Counterfeiter/NespressoBot-PCB/ProductionInfo/silkscreen_example_text_small.jpg

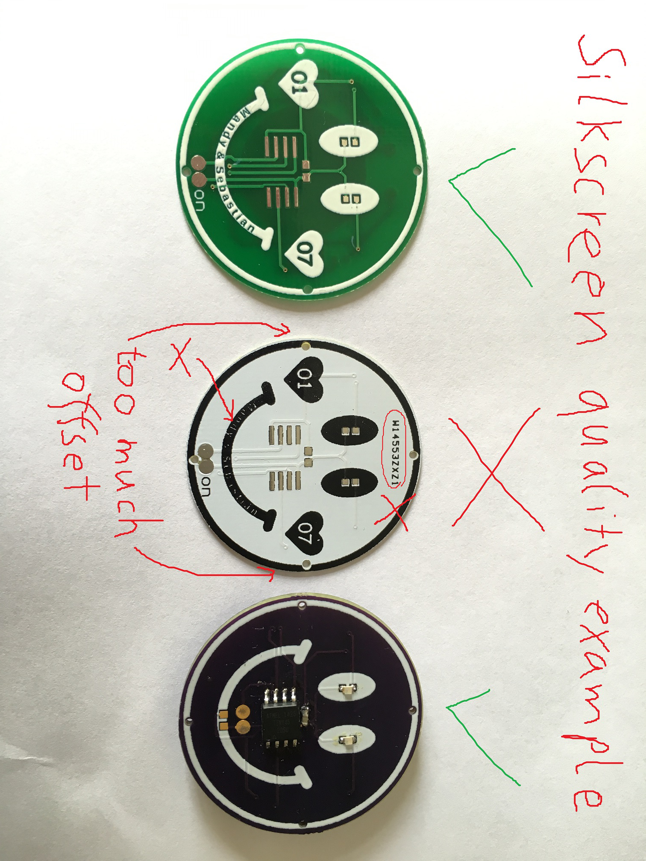
ProductionInfo/silkscreen_example_text_small.jpg
