Counterfeiter/NespressoBot-PCB/Smilie_clean.bmp

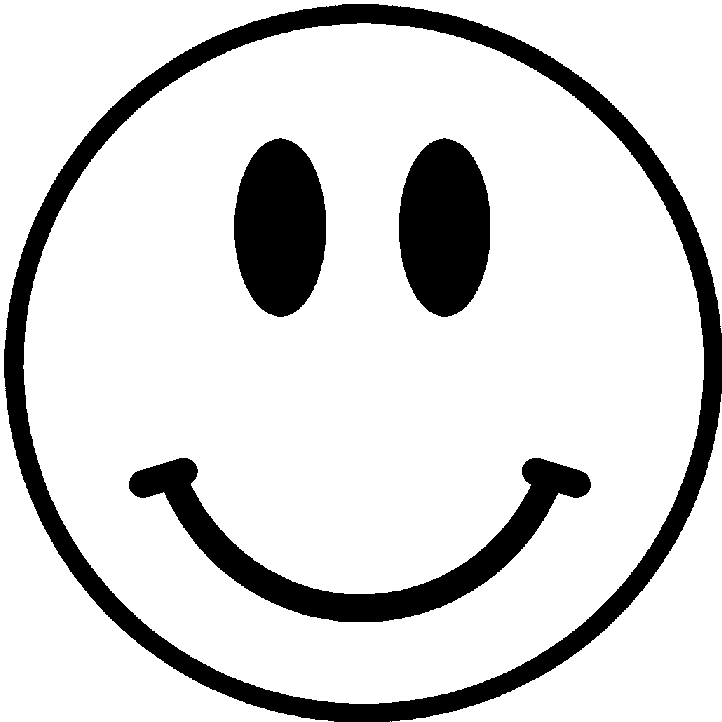
Smilie_clean.bmp
