Counterfeiter/NespressoBot-PCB/smilie_face_raw_small_400dpi.bmp

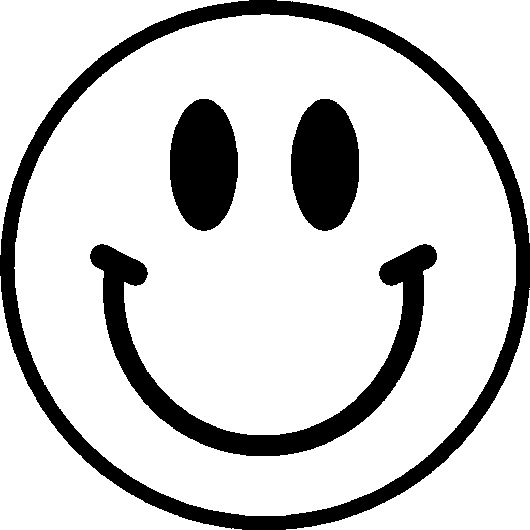
smilie_face_raw_small_400dpi.bmp
