Counterfeiter/NespressoBot-PCB/WeddingBot_BOM.ods

Nr. | Name | Designator | Package | Part-Nr. | Mouser Part-Nr. | Units | Units for Price | Price € | Price*Unit €
1 | CR1220 Battery Holder SMD | U2 |  | S8201-46R | 855-S8201-46R | 1 | 1000 | 0,27 € | 0,27 €
2 | PCB d=35 mm, 1 mm |  |  | Stopcolor: w, Silkscreen: b | good quality | 1 | 1000 | 0,4 | 0,4
3 | Microcontroller | U1 | SO8 | ATTINY45-20SUR | 556-ATTINY45-20SUR | 1 | 1000 | 0,601 | 0,601
4 | Piezo |  |  | 20PCS 27mm Piezo Elements Sounder Sensor Trigger Drum Disc | (Ebay: survy2014) | 1 | 100 | 0,121 | 0,121
6 | Kingbright LED |  | 1206 | APTR3216SGC | 604-APTR3216SGC | 2 | 2000 | 0,05 | 0,1
8 | Res 100 |  | 0603 |  |  | 3 |  | 0,0005 | 0,0015
9 | Cap 100 nF (10 V min) |  | 0603 | C0603C104K4RACTU | 80-C0603C104K4R | 1 | 1000 | 0,005 | 0,005
10 | CR1220 Batterie 50 mAh |  |  | maxell CR1220 | Pollin (270 955)?! | 1 | 100 | 0,47 | 0,47
11 | Eigenleistung |  |  | 10 min (Programmieren, Kleben, Löten, Zurödeln) |  |  |  |  | 0
 |  |  |  |  |  |  | Overall:
 |  |  |  |  |  |  | 1000 |  | 1,9665 | EURO/Unit
 |  |  |  |  |  |  |  |  | 1966,5 | EURO
