Counterfeiter/NespressoBot-PCB/weddingbot.brd

## EAGLE design weddingbot.brd (2018-04-13)

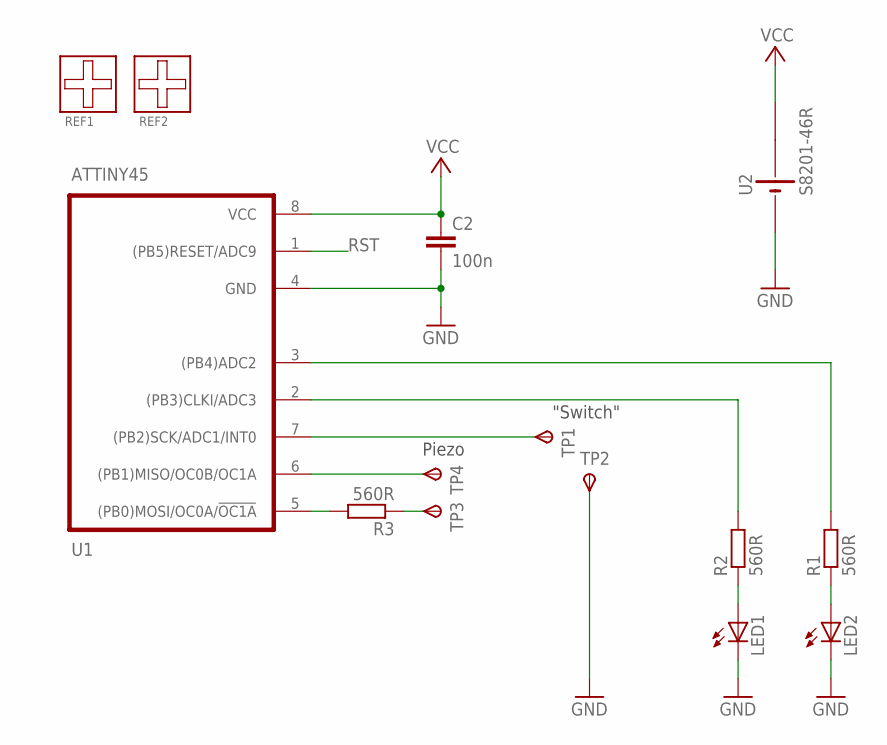
[picture p4: schematic weddingbot.sch]

Parts:
C2: 100n; C0603
LED1, LED2: LEDMEINE; CHIPLED_REV_1206
R1, R2, R3: 560R; R0603
REF1, REF2: FIDUCIAL_ROUND; REF_ROUND
TP1, TP2, TP3, TP4: TPSTP20R; TP20R
U1: ATTINY45; SOIC8
U2: S8201-46R

Connections:
GND: C2.2, LED1.C, LED2.C, TP2.TP, U1.4 (GND), U2.P1 (GND)
unnamed: R3.2, U1.5 ((PB0)MOSI/OC0A/!OC1A)
unnamed: LED2.A, R1.1
unnamed: LED1.A, R2.1
unnamed: TP1.TP, U1.7 ((PB2)SCK/ADC1/INT0)
unnamed: R3.1, TP3.TP
unnamed: TP4.TP, U1.6 ((PB1)MISO/OC0B/OC1A)
NET1: R2.2, U1.2 ((PB3)CLKI/ADC3)
RST: U1.1 ((PB5)RESET/ADC9)
SCK: R1.2, U1.3 ((PB4)ADC2)
VCC: C2.1, U1.8 (VCC), U2.P2 (VV1)

Notes on the sheet:
"Switch"
Piezo

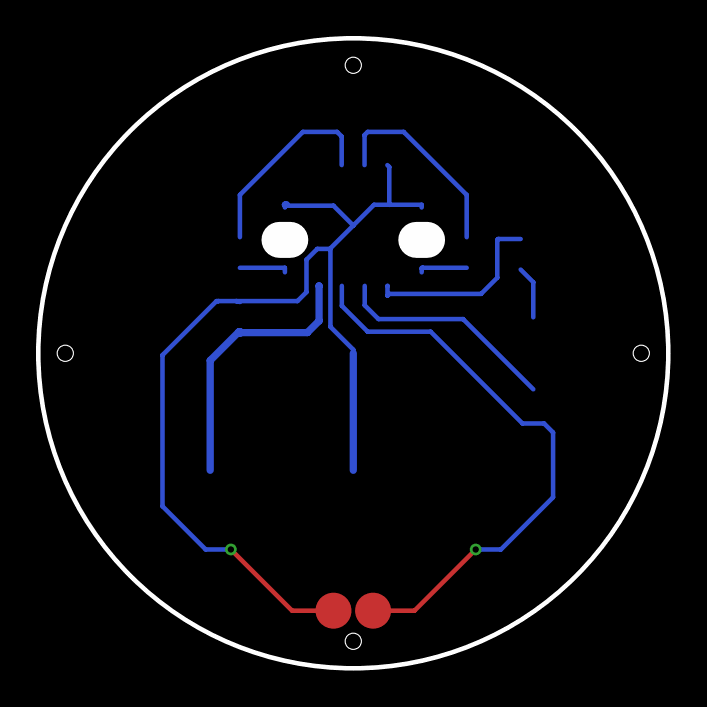
[picture p5: board weddingbot.brd from above]

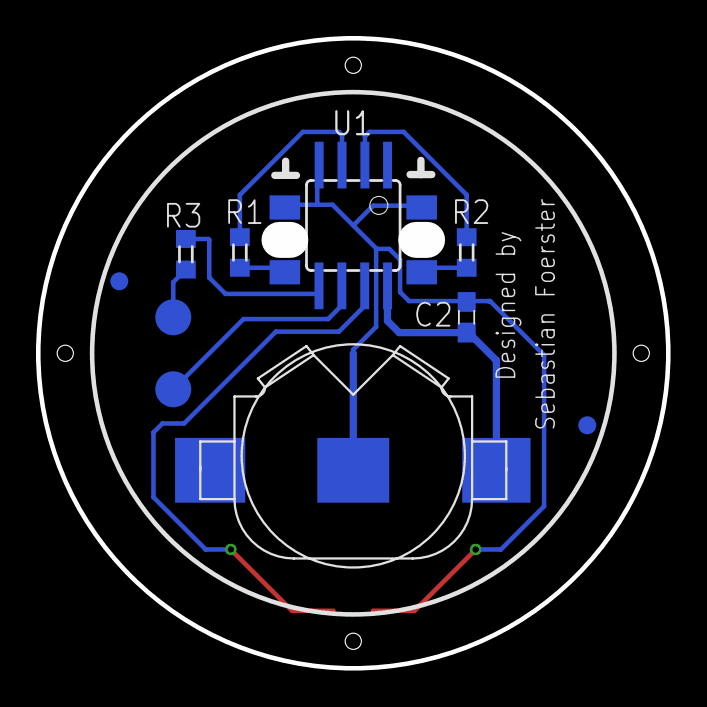
[picture p6: board weddingbot.brd from below]

Board: 2 copper layers, 35.0 x 35.0 mm, 14 parts (12 on the bottom side), 10 nets.
